timsavage/funktion-generator/README.rst

##################
Funktion-generator
##################

AVR based function generator - Hardware + Firmware

Full project details at https://hackaday.io/project/19866

See sub folders for README docs on sub-components.
