timsavage/funktion-generator/user-interface/README.rst

##############
User Interface
##############

User interface and I2C master controller.
