timsavage/funktion-generator/dds-gen/README.rst

#############
DDS Generator
#############

The DDS generate sub component is responsible for generating wave forms and providing amplitude and offset control. The heart of the component is an AVR microcontroller which is being overclocked to 30Mhz. The DDS generator is controlled via the I2C bus.
