timsavage/funktion-generator/dds-gen/hardware/DDS-Gen-Rev1.pdf

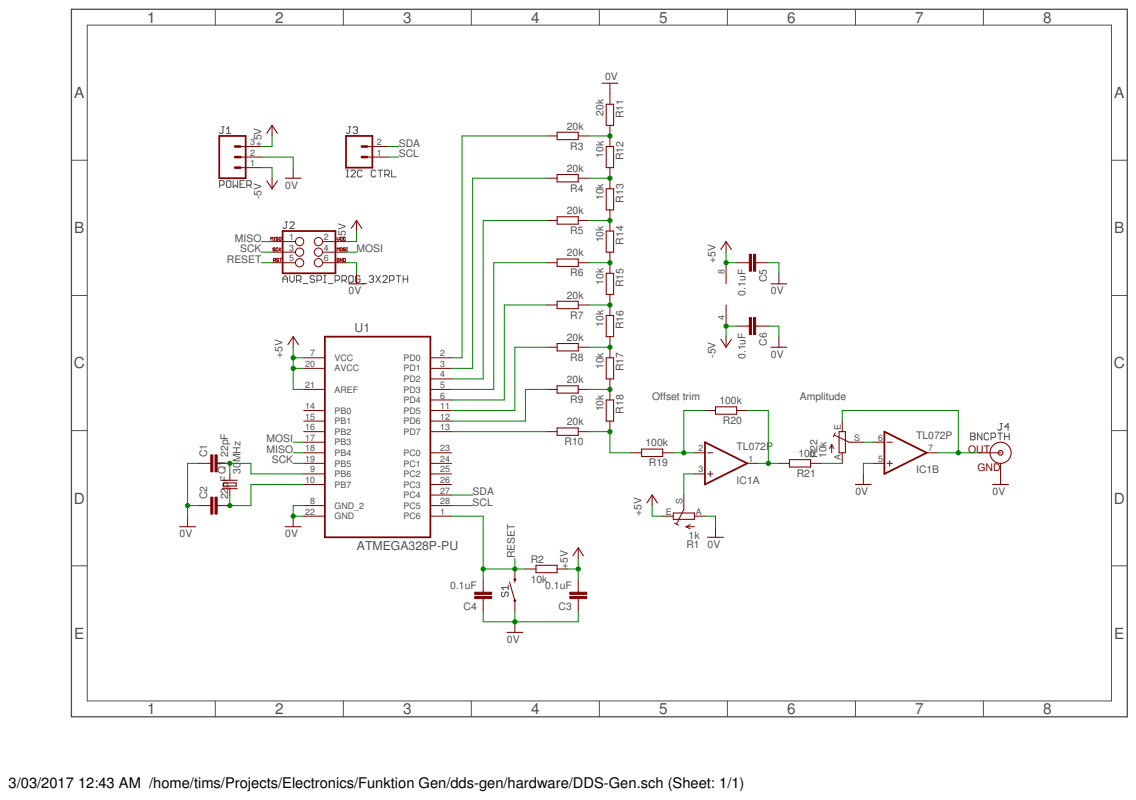
[picture p1: page 1]

3/03/2017 12:43 AM /home/tims/Projects/Electronics/Funktion Gen/dds-gen/hardware/DDS-Gen.sch (Sheet: 1/1)
