timsavage/funktion-generator/power-supply/hardware/power-supply.brd

## EAGLE design power-supply/hardware/power-supply.brd (2017-03-12)

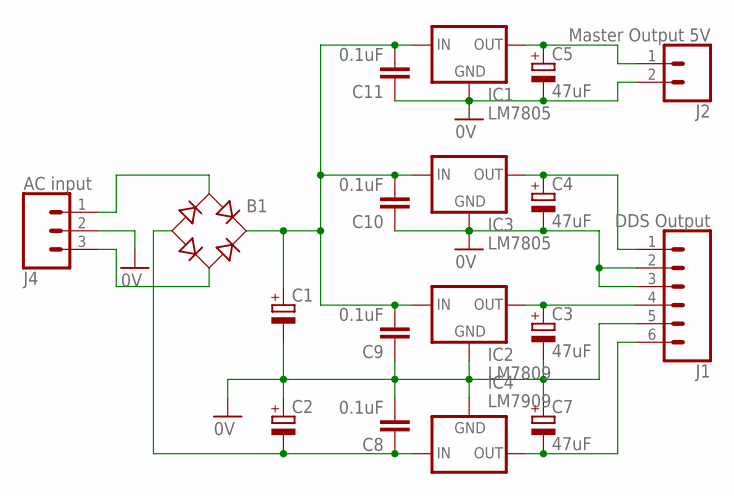
[picture p2: schematic power-supply.sch]

Parts:
B1: RB1A
C1, C2: CPOL-EUE7.5-16; E7,5-16
C3, C4, C7: 47uF; E5-6
C5: 47uF; E2,5-6
C8, C9, C10, C11: 0.1uF; C025-025X050
IC1, IC3: LM7805; 78XXS
IC2: LM7809; 78XXS
IC4: LM7909; 79XXS
J1: DDS Output; MOLEX-1X6
J2: Master Output 5V; MOLEX-1X2
J4: AC input; MOLEX-1X3

Connections:
0V: C1.-, C2.+, C3.-, C4.-, C5.-, C7.+, C8.2, C9.1, C10.1, C11.1, IC1.GND, IC2.GND, IC3.GND, IC4.GND, J1.2, J1.3, J1.5, J2.2, J4.2
5V-DDS: C4.+, IC3.OUT, J1.1
5V-MASTER: C5.+, IC1.OUT, J2.1
9V: C3.+, IC2.OUT, J1.4
-9V: C7.-, IC4.OUT, J1.6
unnamed: B1.+, C1.+, C9.2, C10.2, C11.2, IC1.IN, IC2.IN, IC3.IN
unnamed: B1.-, C2.-, C8.1, IC4.IN
unnamed: B1.AC2, J4.3
unnamed: B1.AC1, J4.1

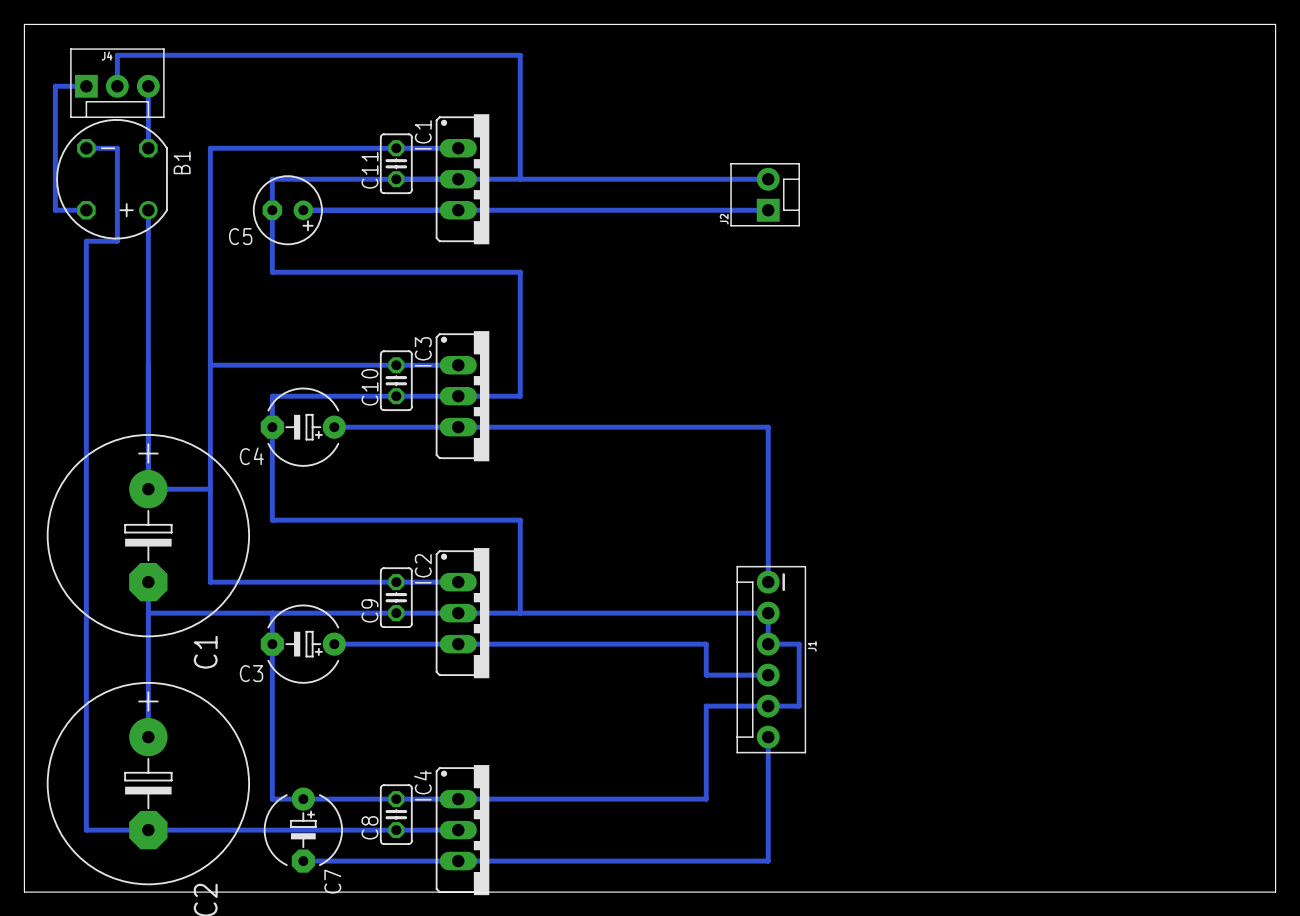
[picture p3: board power-supply.brd from above]

Board: 2 copper layers, 102.5 x 71.1 mm, 18 parts (0 on the bottom side), 9 nets.
