timsavage/funktion-generator/dds-gen/hardware/DDS-Gen.brd

## EAGLE design dds-gen/hardware/DDS-Gen.brd (2017-03-07)

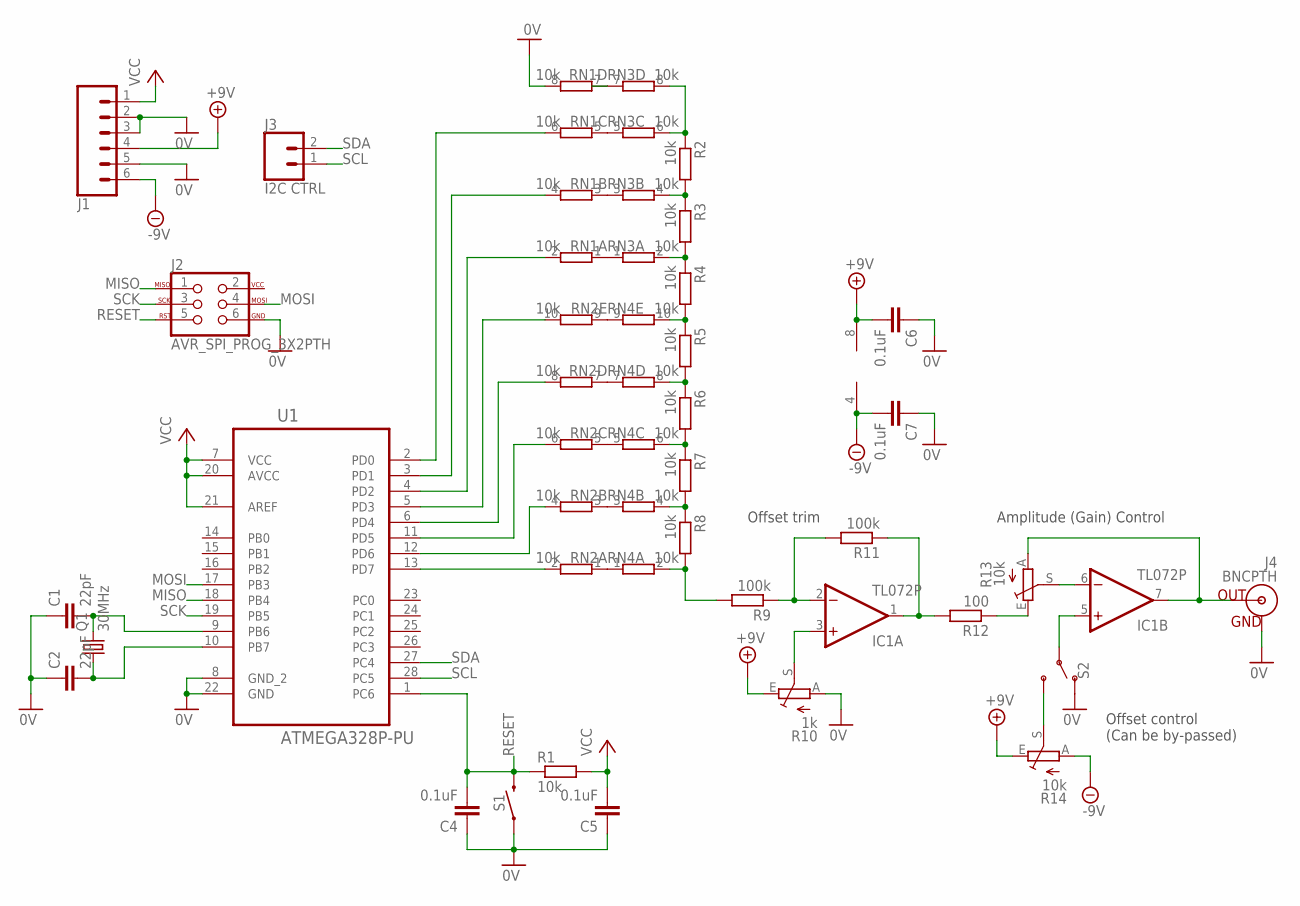
[picture p4: schematic DDS-Gen.sch]

Parts:
C1, C2: 22pF; C025-025X050
C4, C5, C6, C7: 0.1uF; C025-025X050
IC1: TL072P; DIL08
J1: CONN_06POLAR; MOLEX-1X6
J2: AVR_SPI_PROG_3X2PTH; 2X3
J3: I2C CTRL; MOLEX-1X2
J4: BNCPTH; BNC
Q1: 30MHz; HC49/S
R1, R2, R3, R4, R5, R6, R7, R8: 10k; 0204/5
R9: 100k; 0204/5
R10: 1k; S64W
R11: 100k; 0204V
R12: 100; 0207/12
R13, R14: 10k; CIP20C-6MM
RN1, RN2, RN3, RN4: 10k; SIL10
S1: MOMENTARY-SWITCH-SPST-PTH-6.0MM; TACTILE_SWITCH_PTH_6.0MM
S2: SWITCH-SPDT-PTH-11.6X4.0MM; SWITCH_SPDT_PTH_11.6X4.0MM
U1: ATMEGA328P-PU; DIP254P762X457-28

Connections:
0V: C1.1, C2.1, C4.1, C5.1, C6.1, C7.1, J1.2, J1.3, J1.5, J2.6, J4.GND, R10.A, RN1.8 (2), S1.1, S2.1 (O), U1.8 (GND_2), U1.22 (GND)
+9V: C6.2, IC1.8 (V+), J1.4, R10.E, R14.E
-9V: C7.2, IC1.4 (V-), J1.6, R14.A
MISO: J2.1, U1.18 (PB4)
MOSI: J2.4, U1.17 (PB3)
unnamed: C2.2, Q1.1, U1.10 (PB7)
unnamed: C1.2, Q1.2, U1.9 (PB6)
unnamed: IC1.3 (+IN), R10.S
unnamed: IC1.2 (-IN), R9.1, R11.2
unnamed: RN2.2, U1.13 (PD7)
unnamed: RN2.4 (2), U1.12 (PD6)
unnamed: RN2.6 (2), U1.11 (PD5)
unnamed: RN2.8 (2), U1.6 (PD4)
unnamed: RN2.10 (2), U1.5 (PD3)
unnamed: RN1.2, U1.4 (PD2)
unnamed: RN1.4 (2), U1.3 (PD1)
unnamed: RN1.6 (2), U1.2 (PD0)
unnamed: IC1.5 (+IN), S2.2
unnamed: R14.S, S2.3 (S)
unnamed: R12.1, R13.E
unnamed: IC1.1 (OUT), R11.1, R12.2
unnamed: IC1.6 (-IN), R13.S
unnamed: IC1.7 (OUT), J4.S (OUT), R13.A
unnamed: RN2.1, RN4.1
unnamed: RN2.3 (1), RN4.3 (1)
unnamed: RN2.5 (1), RN4.5 (1)
unnamed: RN2.7 (1), RN4.7 (1)
unnamed: RN2.9 (1), RN4.9 (1)
unnamed: RN1.1, RN3.1
unnamed: RN1.3 (1), RN3.3 (1)
unnamed: RN1.5 (1), RN3.5 (1)
unnamed: RN1.7 (1), RN3.7 (1)
unnamed: R2.1, RN3.6 (2), RN3.8 (2)
unnamed: R2.2, R3.1, RN3.4 (2)
unnamed: R3.2, R4.1, RN3.2
unnamed: R4.2, R5.1, RN4.10 (2)
unnamed: R5.2, R6.1, RN4.8 (2)
unnamed: R6.2, R7.1, RN4.6 (2)
unnamed: R7.2, R8.1, RN4.4 (2)
unnamed: R8.2, R9.2, RN4.2
RESET: C4.2, J2.5, R1.1, S1.3 (2), U1.1 (PC6)
SCK: J2.3, U1.19 (PB5)
SCL: J3.1, U1.28 (PC5)
SDA: J3.2, U1.27 (PC4)
VCC: C5.2, J1.1, R1.2, U1.7 (VCC), U1.20 (AVCC), U1.21 (AREF)

Notes on the sheet:
Offset trim
Amplitude (Gain) Control
Offset control (Can be by-passed)

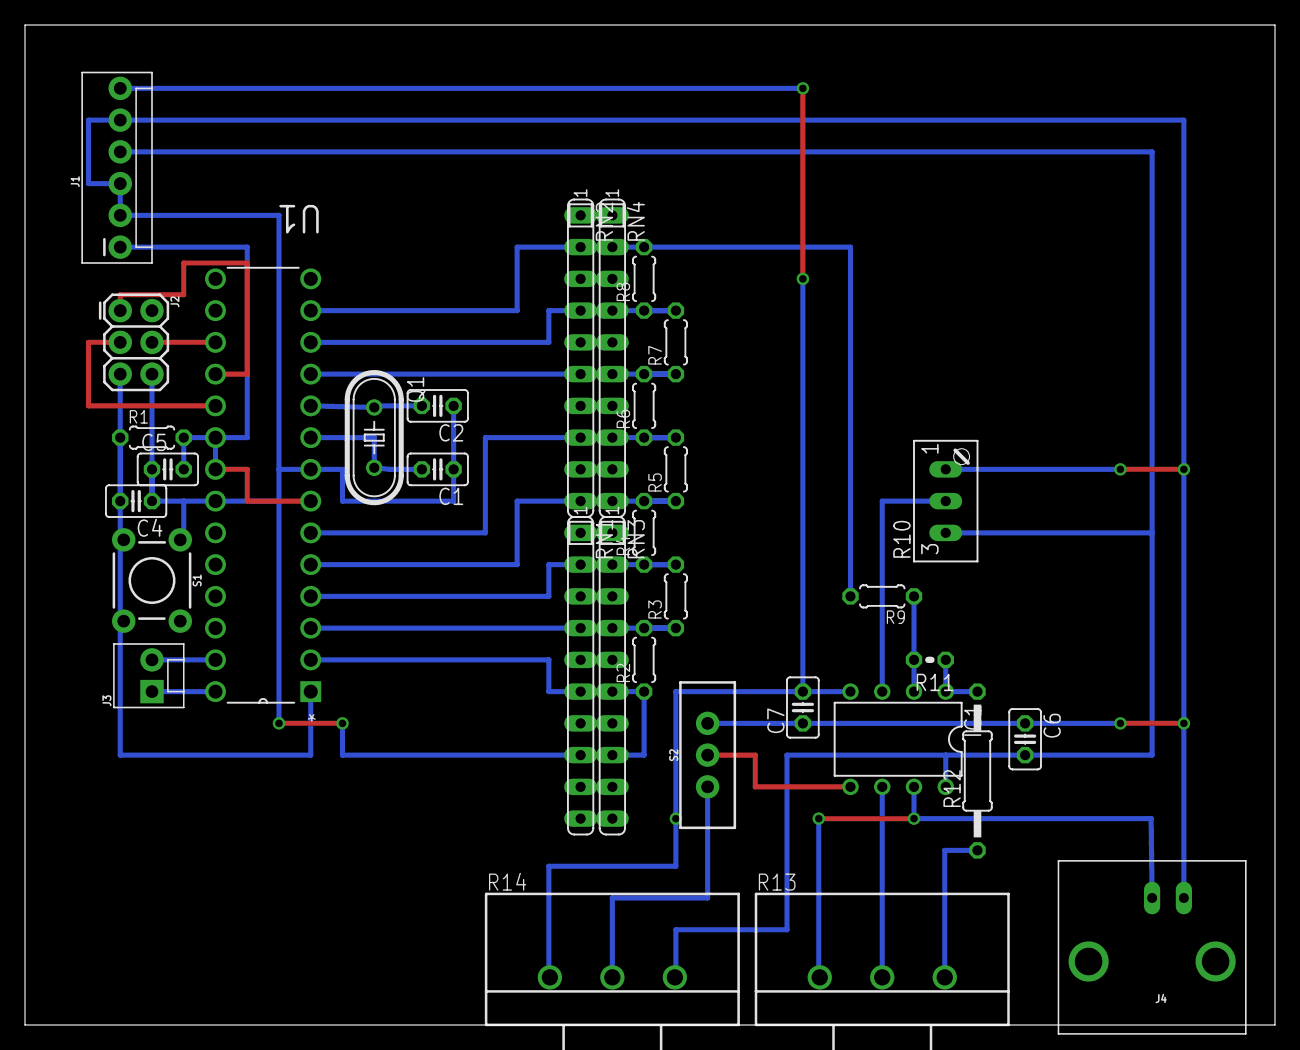
[picture p5: board DDS-Gen.brd from above]

Board: 2 copper layers, 100.0 x 80.0 mm, 33 parts (0 on the bottom side), 45 nets.
