timsavage/funktion-generator/(commit log)

2017-02-09 Added commands to control the device
2017-02-09 Updates to simplify the build and make process, fixed a couple of bugs and made the .S more compatible with .as
2017-03-02 Added DDS-Gen schematic
    [DDS-Gen.brd, DDS-Gen.sch]
2017-03-03 Updates begin layout of board, switched to ganged resistors
    [DDS-Gen.brd, DDS-Gen.sch]
2017-03-05 Layout tweaks and offset control.
    Added switchable offset control to output amplifier. Can be switched in or out.
    Tweak to layout so pots work in a natual manner (eg clockwise to increase amplitude)
    [DDS-Gen.brd, DDS-Gen.sch]
2017-03-07 Updated Schematic with slit power supply +-9V and 5V
    [DDS-Gen.brd, DDS-Gen.sch]
2017-03-12 Added power-supply hardware design
    [power-supply.brd, power-supply.sch]
2017-03-13 Split and improved export (formatter)
    Moved the ASM export functionality into a formatter object, decoupling
    export from the wave table.
    Added support for AVR Assembler (AVRASM2) in addition to GCC.
2017-04-06 Wave functions, simplification and undo.
    Added new wave functions, rectify_wave, normalise_wave and centre_wave. Each
    of these functions do as advertised.
    Some simplification to the internal code to allow addition of new wave functions
    easier, no longer does the same wave function need to be replicated in 4 places.
    This also leads into undo support. There is an unlimited undo buffer per wave
    editor. There is not currently support for redo, although this could be done
    without a huge amount of effort.
2017-04-09 More work on the UI to display current state.\nInitilisation process is roughed out some refactors may be required to decouple parts of the code
2017-04-10 Started adding zeroconf device discovery
2017-04-10 Added initial device and discovery code
2017-04-10 Added mouse wheel zoom, wired up initial events from devices list
